sujal128005/navya_autonomouscar/docs/report/steering_marked.jpg

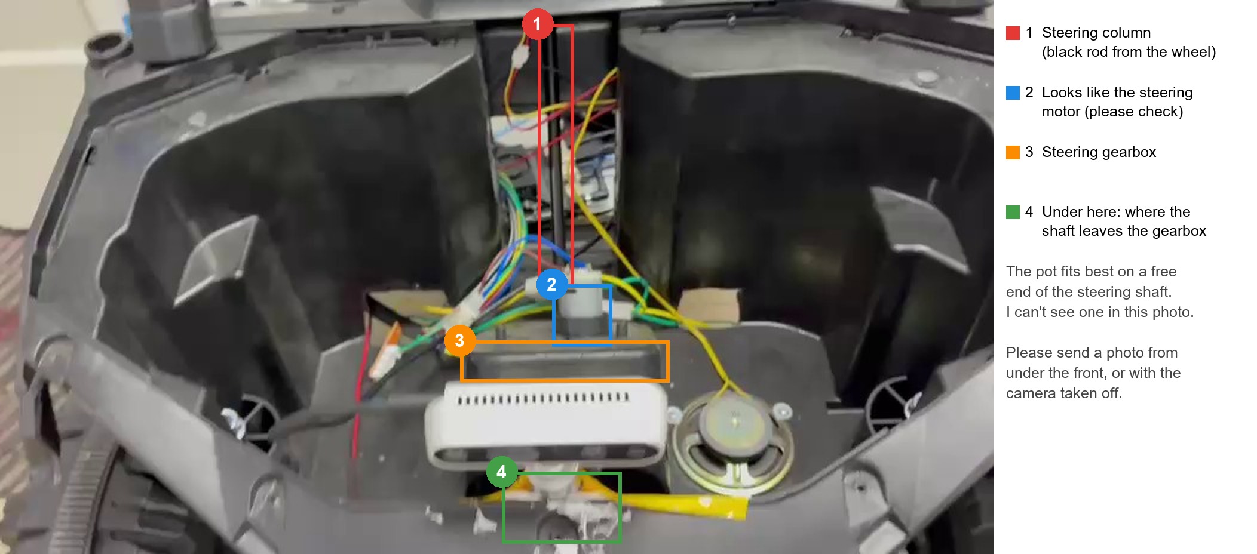
docs/report/steering_marked.jpg
