sujal128005/navya_autonomouscar/docs/wiring/photos/camera_front.jpg

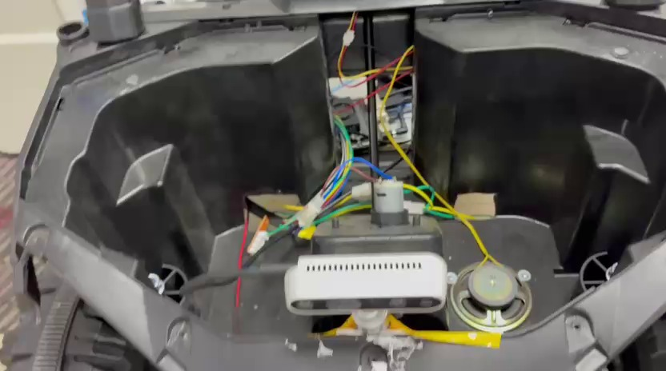
docs/wiring/photos/camera_front.jpg
