sujal128005/navya_autonomouscar/README.md

# Navya



Autonomous car built on a TZ-306 4x4 ride-on, on a student budget.

**Demo 1 (current):** drive along a straight path, see an obstacle with the
Intel RealSense D435i, slow down, stop before it, and move off again by itself
once the obstacle is taken away.

## How it works

```
 D435i depth ──USB3──► Laptop: autopilot/navya_autopilot.py
                         finds the nearest thing inside the car's path
                         picks a speed: cruise / slow / stop / resume
                              │ USB serial "D,<left>,<right>,<brake>" at 30 Hz
                              ▼
 FlySky FS-R6B ──CH2,CH5──► Arduino Uno: firmware/navya_drive
                         MANUAL / AUTO / NO_RC modes, safety stops
                              │ throttle PWM + brake per wheel
                              ▼
                  2x YL-12 controller ──► 2x 8" BLDC rear hub motor
```

Front wheels are passive: steering is zip-tied straight and the three front
toy motors are disconnected. The car (~31 kg) drives on the two rear hubs only.

The Arduino is in charge of safety. The car stops if any of these happen:

| Event | Result |
|---|---|
| CH5 switch not in AUTO | laptop commands ignored (MANUAL: stick drives) |
| Right stick (CH2) pulled back | stop + brake, in any mode |
| No receiver signal for 0.1 s | stop + brake |
| No laptop command for 0.3 s (crash, cable out) | stop + brake |
| Camera stops sending frames | laptop sends stop |
| Something right against the lens (no depth) | treated as an obstacle |

## Hardware

| Part | Used for |
|---|---|
| 2x 8" BLDC hub motor, 24 V 350 W, drum brake | rear drive |
| 2x YL-12 brushless sine-wave controller (24 V, 16 A, brake active low, cut-off 21 V) | one per hub |
| 2x 6S LiPo 22.2 V 5200 mAh | motor power |
| Arduino Uno | throttle/brake output, RC input, safety |
| FlySky FS-CT6B transmitter + FS-R6B receiver | manual driving, AUTO switch, stop |
| Intel RealSense D435i | obstacle depth |
| Laptop (Windows, Python) | autopilot |
| LDROBOT D500 LiDAR (STL-19P), on the laptop's USB | optional second obstacle sensor (`--lidar`) |
| Raspberry Pi 3B | not used yet |

## Wiring

### Arduino Uno pins (firmware v2)

| Uno pin | Goes to |
|---|---|
| D9 | LEFT controller throttle signal (purple) |
| D10 | RIGHT controller throttle signal (purple) |
| D8 | LEFT controller F/R (silver) |
| D7 | RIGHT controller F/R (silver) |
| **D11** | LEFT controller brake wire (optional), **moved from D5 in v2** |
| **D12** | RIGHT controller brake wire (optional), **moved from D6 in v2** |
| GND | BOTH controllers' throttle black wires and F/R black wires |
| D3 | receiver CH2 signal pin (right stick up/down) |
| D2 | receiver CH5 signal pin (AUTO switch) |
| **D4** | receiver **CH1** signal pin (right stick left/right = manual steering) |
| 5V / GND | receiver + / − (any channel's middle / outer pin) |
| **D5** | BTS7960 **RPWM** |
| **D6** | BTS7960 **LPWM** |
| **A3** | BTS7960 **R_EN and L_EN** (both) |
| **5V / GND** | BTS7960 **VCC / GND** |
| **A0** | steering potentiometer **middle pin** (outer pins to 5V and GND) |
| **A1** | LEFT limit switch, other side to GND (closed = at full left) |
| **A2** | RIGHT limit switch, other side to GND (closed = at full right) |
| USB | laptop |

### Battery monitor (optional, 4 resistors)

For each LiPo, wire: **LiPo + → 47 kΩ → Uno pin → 10 kΩ → GND**.
- Left battery to **A4**, right battery to **A5**.
- The battery negatives must be joined to the Arduino GND (see Power).
- Full charge (25.2 V) reads as about 4.4 V at the pin, safely under 5 V.

The phone, terminal and trip log then show each battery's voltage and %:
- **below 22.2 V:** a warning;
- **below 21.6 V for 3 s while driving:** the car stops and stays stopped until restarted.

This happens before the controllers would cut out at 21 V mid-run. If the readings are
slightly off against a multimeter, adjust `BATT_ADC_REF_V` in the firmware.

### Steering (the toy's own steering motor)

- **Disconnect the toy's blue control board from the steering motor.** Its two motor wires
  go to the BTS7960 **M+ / M−**.
- **BTS7960 B+ / B−** ← the car's **12 V battery**, through an **inline 10 A fuse** on B+.
- **Potentiometer:** fix its body to the chassis and couple its shaft to the steering shaft
  (rubber or plastic tube, or a 3D-printed adapter), so it turns with the steering. Set it
  roughly mid-way when the wheels are straight, so neither lock reaches the pot's own end.
- **Limit switches:** mount one at each lock so the linkage presses it just before the
  hard stop.
- The BTS7960's R_IS / L_IS pins are not used.
- Firmware safety: the steering motor stops on a limit switch, when the pot stops moving
  for 1.5 s while driven (stall), when the pot wire looks broken, with no radio, and
  until the steering has been calibrated.

Controller plug colours, from our bring-up:

- **Throttle plug:** black = GND, orange = +5 V out (leave unconnected), purple = signal.
- **F/R plug:** black = GND, silver = signal. Leaving it open means forward. If a wheel ever
  spins backwards, set `INVERT_LEFT` or `INVERT_RIGHT` in the firmware.
- **Brake (optional):** "Brake: Low" means pulling the brake wire to GND brakes. Without it,
  a stop is just throttle off and coast, so keep the stop distance generous.

The Uno's GND must connect to both controllers' throttle GND. Without that shared
ground the throttle signal means nothing.

Recommended additions, all cheap:

- **10 kΩ resistor** from each purple throttle wire to GND, so a disconnected or
  resetting Arduino reads as zero throttle.
- **Kill switch:** route both controllers' power-lock (ignition) wires through one
  toggle switch that someone can reach. Opening it cuts both motors, whatever the
  software is doing.

### Power

- One 6S LiPo per controller works fine. Join the two battery negatives with a proper
  wire so motor current never flows through the Arduino's ground.
- Full charge is 25.2 V; the controllers cut out at 21 V (3.5 V per cell), which
  also protects the LiPos.
- Power the Arduino before (or together with) the controllers. They refuse to start
  if they see throttle applied at power-on.
- Unplug the LiPos when the car is not being tested.

## Software setup

### 1. Flash the Arduino

1. Open `firmware/navya_drive/navya_drive.ino` in the Arduino IDE.
2. Choose board **Arduino Uno** and the right port, then click Upload.
3. Open the Serial Monitor at **250000** baud. You should see `NAVYA READY v2`, then
   `S,...` status lines 10 times a second, starting
   `S,<mode>,<CH2 µs>,<CH5 µs>,<laptop ok>,<pwm left>,<pwm right>,<brake>,...`
   (the comment at the top of the firmware lists all 17 fields).

### 2. Laptop

Python 3.10 or newer. The D435i must be on a **USB 3** (blue) port.

```bash
cd autopilot
pip install -r requirements.txt
python test_logic.py
```

`test_logic.py` checks the obstacle maths and speed logic with simulated depth
images. It needs no hardware. GitHub also runs it, and compiles the Arduino firmware,
on every push (`.github/workflows/ci.yml`): the badge at the top turns red if
something broke. Check it is green before taking the car out.

All tunable numbers live in `autopilot/config.py`.

### 3. Jetson Orin Nano (onboard computer)

The same code runs on a Jetson Orin Nano with JetPack 6.2 (Python 3.10). Set up and
tested on 3 Nov 2026 at the desk; not yet on the car.

1. Once, with the Jetson password:
   - remove `brltty` (Ubuntu's braille driver grabs the Arduino's CH340 chip);
   - install `python3-venv`;
   - add the RealSense USB rule.

   `bash jetson/setup_jetson.sh` prints the exact command if any of this is missing.
2. `bash jetson/setup_jetson.sh` creates `.venv`, Navya's own Python, so other projects
   on the Jetson keep their packages. It installs:
   - NVIDIA's GPU PyTorch (torch 2.8.0 from `pypi.jetson-ai-lab.io/jp6/cu126`);
   - RealSense, ultralytics, pyserial;
   - numpy 1.x, which the Jetson torch build needs. That's why OpenCV is pinned below 4.12.
3. Object detection:
   - put `yolo11n.pt` in `autopilot/models/`, then run `python export_models.py`;
   - it builds `yolo11n.engine` (TensorRT, FP16, about 7 minutes): 23 ms per image on the GPU.
4. Every session, from the laptop: **double-click `Navya Jetson.bat`**. It:
   - finds the Jetson on the laptop's current Wi-Fi (`jetson/find_jetson.py`) and remembers it;
   - opens the Navya menu (`navya.sh`) **on the Jetson**, after fetching the latest code;
   - opens the dashboard in the laptop's browser as soon as a drive or viewer starts.

   Q quits, as on the laptop. Without a screen (over SSH), the viewers and `--show` appear
   on the dashboard instead of in windows.

**Network:**
- the laptop and the Jetson must share one Wi-Fi: a phone hotspot or the laptop's Mobile
  hotspot. College Wi-Fi blocks device-to-device traffic.
- `ssh jetson` uses the key `~/.ssh/navya_jetson`, plus a `Host jetson` entry in
  `~/.ssh/config` that `find_jetson.py` keeps up to date.

**On the Jetson:**
- the Arduino needs the CH340 driver: `bash jetson/build_ch341.sh` (once, and after
  JetPack updates);
- serial ports are `/dev/ttyUSB*`; auto-detection picks the Arduino (CH340) and the LiDAR
  (CP210x);
- trip recordings go to the Samsung T7 SSD (`/mnt/t7ssd/navya_trips`). Plug it in before
  switching the Jetson on, or run `sudo mount /mnt/t7ssd`;
- plug the camera straight into a Jetson USB port. Through a USB-C dock it fails to start.

## Bring-up, in this order

**Every step until step 7 is done with the car on blocks (rear wheels off the ground).**

1. **Radio check.** In the Serial Monitor, move the right stick: the CH2 value must
   go up and down (~1000–2000). Flip the CH5 switch: the mode must change between
   `MANUAL` and `AUTO`.
   - If CH5 doesn't respond, your switch is on another channel. Move the D2 wire to
     the channel that changes.
   - The CT6B's knobs and switches can be reassigned with the FlySky T6 config tool.
2. **Signal-loss check.** Turn the transmitter off. The mode must change to `NO_RC`
   within a moment.
   - If it stays `MANUAL`/`AUTO`, the receiver is repeating its last signal. In that
     case the transmitter is **not** a dead-man switch: fit the kill switch from
     *Recommended additions* (Wiring) before any ground run.
3. **Manual drive.** CH5 in MANUAL, push the right stick up gently: both wheels must
   turn forward. Pull it back: brake.
4. **Find the throttle range.** CH5 in AUTO:
   ```bash
   python throttle_test.py --sweep
   ```
   - Note the first PWM at which both wheels turn and put it in `PWM_START` in the
     firmware.
   - Pick a `PWM_MAX` that gives a safe top speed. Start low (start + 40); 31 kg takes
     a while to stop. Re-upload.
   - Check both wheels together with `python throttle_test.py --speed 500`.
5. **Mount and calibrate the camera.** Mount it facing straight ahead, level
   side-to-side and tilted slightly down. Put the car on the floor with 2 m of
   empty floor ahead, then run:
   ```bash
   python calibrate_camera.py --write
   ```
6. **Camera-only check.** No motors are driven in this step:
   ```bash
   python navya_autopilot.py --dry-run --show
   ```
   - Walk in front of the car. The white overlay marks what counts as an obstacle,
     and the floor must **not** be white.
   - Watch the state go `CLEAR → SLOWING → STOPPED` as you get closer, and back to
     `RESUMING → CLEAR` 0.5 s after you step away.
7. **First ground run.** Keep `CRUISE_SPEED` low in `config.py` (130 is our tested value).
   1. Place a cardboard box about 5 m ahead.
   2. CH5 to MANUAL, then run `python navya_autopilot.py --show`.
   3. Flip CH5 to AUTO. The car moves off after 0.5 s.
   4. Measure where it actually stops. Raise `STOP_DIST_M` if it stops too close,
      then raise speed step by step.

## One-click launcher

Double-click **`Navya.bat`** in the repository folder (or make a desktop shortcut to it:
right-click > Send to > Desktop). It opens a menu:

```
 1  Pre-flight check
 2  Drive          (watch on phone)
 3  Drive + object detection + record trip
 4  Drive + lane following (steering)
 5  Drive with everything (detection, steering, record)
 L  Drive + LiDAR  (LiDAR plugged into the laptop)
 6  Camera test    (no Arduino, car never moves)
 7  Corridor viewer   8  Object detection viewer   9  LiDAR radar view
 C  Calibrate camera  S  Calibrate steering  R  Report of the last trip  T  Run the logic tests
```

Option **L** drives with the LiDAR as a second obstacle sensor (plug it in first). Every
drive option runs the pre-flight check first. If anything fails, it asks before
driving. When the program ends, press a key to get back to the menu.

## Pre-flight check (run this first, every time)

```bash
python preflight.py
```

It checks, and tells you how to fix anything wrong:
- Python packages, and that the Arduino IDE / Serial Monitor is closed;
- Arduino connected with firmware v2, transmitter on, CH5 in MANUAL, stick centred;
- steering calibrated, and battery voltages;
- camera on USB 3 and still matching its calibration (warns if it was knocked);
- LiDAR spinning and sending scans (if plugged in);
- SD card and free space, object-detection backend, hotspot on, port 8080 free, Ask Navya key.

It never moves the car. `READY` at the end means go.

## Demo-day checklist

1. LiPos charged (above 24 V).
2. Transmitter on, **SWA down** (SWA up is dual rate and shortens the stick travel),
   CH5 in **MANUAL**, right stick centred.
3. Laptop: `python navya_autopilot.py --show`, and wait for `Running`.
4. A person holds the transmitter for the whole run, ready to pull the stick back.
5. Flip CH5 to **AUTO**. The car drives off.
6. Step in front of it (or slide a box in): it slows and stops. Step away: after
   0.5 s it moves off again.
7. End the run with CH5 back to MANUAL. On the laptop, SPACE pauses and Q quits.

## Trip recorder

Add `--record` to save every run:

```bash
python navya_autopilot.py --phone --vision --record
```

Each run gets its own folder, `trip_YYYYMMDD_HHMMSS`, under `navya_trips` on the **SD card**
(found automatically when inserted), or under `autopilot/recordings` if there is none. It contains:

| File | What |
|---|---|
| `camera.mp4` | camera picture with status text and detection boxes, real-time speed |
| `depth.mp4` | depth view, with the obstacle zone in white |
| `lidar.mp4` | only with `--lidar`: the radar view |
| `telemetry.csv` | 10 rows/s: mode, state, obstacle distance, speeds, brake, PWM, RC sticks, vision reason, objects, steering, battery volts, LiDAR distance (opens in Excel) |
| `report.png` | made by `trip_report.py` (below) |
| `raw.bag` | only with `--record-raw`: the full camera data for `--replay` |

- **Disk space:** the videos use about 15 GB per hour, and `--record-raw` adds about 100 GB per hour.
  Recording stops by itself when less than 2 GB is free; the car keeps driving.
- **Trip report:** `python trip_report.py` charts the newest trip (obstacle distance, speed, state)
  and prints stop counts and time in each state. `python trip_report.py <folder>` picks a specific one.
- **Replay:** `python navya_autopilot.py --replay <trip>/raw.bag --show --vision` runs the recorded
  camera data through the current settings. It never drives the car. Use it to tune `config.py`
  and see what the car *would* have done.

## Watch from a phone

The laptop rides in the car, so add `--phone` and open the views in any phone browser:

```bash
python navya_autopilot.py --phone          # camera, depth, mode, state, obstacle distance, speed
python corridor_view.py --phone            # camera + bird's-eye map, 3D map, lane, obstacle
```

1. On the laptop, turn on **Mobile hotspot** (Windows Settings → Network → Mobile hotspot), and
   connect the phone to it. Campus Wi-Fi often blocks phone-to-laptop traffic; the hotspot
   always works.
2. The program prints the addresses to open, for example `http://192.168.137.1:8080`. Use the
   `192.168.137.x` one when on the hotspot.
3. The phone shows the live pictures and a status bar. The mode turns **green in AUTO**, yellow
   in MANUAL and red with no radio. "NO UPDATES" means the program stopped.

**Live tuning:** open **"Tune settings (live)"** on the autopilot page.
- The sliders cover cruise speed, slowest speed, start boost, slow-down and stop distances,
  resume wait, person margin, lane lookahead and trim.
- Changes apply **immediately** while driving. **Save settings** writes them into `config.py`;
  without saving, they reset when the program restarts.
- Values are limited to safe ranges, and related distances adjust themselves. For example, the
  resume distance always stays beyond the stop distance.

**Ask Navya:** tap it (optionally type a question) and a free vision AI describes the current
camera picture: people, obstacles, signs. The answer appears on the page a few seconds later.
- **It only describes; it never drives.**
- **Fallback:** it tries **Google Gemini** first (`gemini-3.5-flash-lite`). If that fails (free
  limit reached, error, timeout, empty answer), it asks **Groq** (`qwen/qwen3.8-27b`). The answer
  says which one replied, e.g. `[Gemini, 2 s]` or `[Groq, 3 s - Gemini: free limit reached]`.
  The order and models are in `config.py` (`ASK_PROVIDERS`, `GEMINI_MODEL`, `GROQ_MODEL`).
- **Free keys, no card needed:**
  1. **Gemini:** [aistudio.google.com](https://aistudio.google.com) → *Get API key*.
  2. **Groq:** [console.groq.com](https://console.groq.com) → *API Keys*.
  3. Copy `autopilot/keys.env.example` to `autopilot/keys.env` and paste the keys there.
     `keys.env` is git-ignored, so the keys never go to GitHub.
  4. One key works; two give the fallback.
- **Needs internet on the laptop.** Phones on the laptop's hotspot share the laptop's internet.
- **Free tiers may use what you send** (camera pictures of the corridor) to improve the
  provider's products, so avoid using it in private spaces.

The autopilot page has **Pause** and **Resume** buttons. Pause holds the car stopped, the same as
SPACE on the laptop. Wi-Fi can lag or drop, so **the transmitter stays the emergency stop**.
The first time, Windows may ask whether Python may use the network: allow it.

## Object detection

**YOLO11n** finds people, chairs, bags, bottles, bicycles, cars, stop signs and more in the
colour image. With the D435i, each object also gets its distance and side
(e.g. *person 2.3 m ahead*).

The model file is not in the repo. Download it once into `autopilot/models/`:

```bash
curl -L -o autopilot/models/yolo11n.pt https://github.com/ultralytics/assets/releases/download/v8.3.0/yolo11n.pt
```

Then:

```bash
cd autopilot
python vision_view.py              # D435i: objects + distance
python vision_view.py --webcam     # laptop webcam: objects only (no depth)
python vision_view.py --phone      # also on the phone page
```

- **Speed:** run `python export_models.py` once after downloading the model (needs
  `pip install openvino`). The detector then uses OpenVINO on the Intel GPU automatically:
  19 ms per frame (about 50 fps) on this laptop. Without OpenVINO it falls back to ONNX on the CPU
  (38 ms), then to PyTorch (about 75 ms).
- **Tuning:** `DETECT_CLASSES`, `DETECT_CONFIDENCE` and `DETECT_IMAGE_SIZE` in `config.py`
  control what it looks for, how sure it must be, and speed vs. small-object range.
- **Distance:** the nearer part of the middle of each box, so background showing around a person
  doesn't count.
- `vision_view.py` only looks. To drive with it, use the autopilot's `--vision` option (below).

### Driving with object detection

```bash
python navya_autopilot.py --phone --vision
```

- **People in or near the path:** the car stops `PERSON_EXTRA_MARGIN_M` (1 m) further away than
  for other obstacles, at 3.0 m instead of 2.0 m.
- **Stop sign within 2.5 m:** the car stops, waits 3 s, drives on, and ignores stop signs for 5 s
  so it can pass the sign. The phone and terminal show `STOP_SIGN` and the countdown.
  - **Print one:** a red octagon with white "STOP", at least A4 size.
  - **Place it beside the path** (0.5–1 m to the side, 0.5–1 m high) so the camera sees it. If you
    put it *in* the path, the depth check treats it as an obstacle and waits until it's removed.
- **Detection can only make the car more careful.** It runs in a separate thread; the depth
  obstacle check still runs every frame. If detections are late (over 0.5 s), they're ignored and
  the car behaves exactly as without `--vision`.
- Model loading adds about 8 s at start-up.

## Steering and lane following

### 1. Calibrate the steering (once, and again if the pot is moved)

Upload firmware v2, close the Arduino IDE, set the transmitter to **AUTO** (stick centred), then:

```bash
python steering_calibrate.py
```

1. It pulses the motor and asks **which way the wheels turned**. Answer `l` or `r`.
2. It drives to **full left and full right**, stopping at the limit switch or the end stop.
3. It moves to the middle. Nudge with **A / D** until the wheels point **straight**, then press
   **Enter**.
4. It tests left, straight, right. Positions are stored in the Arduino (EEPROM).
5. Measure the **front-wheel angle at full lock** and put it in `STEER_MAX_DEG` in `config.py`.

After that, **MANUAL mode steers with the right stick (left/right)**. Check the stick's centre
value in the Serial Monitor (the 9th field of `S,` lines) and set `RC_STEER_CENTER_US` in the
firmware if it isn't about 1500.

### 2. Lane following

```bash
python navya_autopilot.py --phone --steer
```

- The lane is the free corridor between the walls (depth camera).
- **Pure pursuit** aims at the lane centre `LOOKAHEAD_M` (1.5 m) ahead and steers along the
  arc that reaches it (wheelbase 0.745 m). It never asks for more than about 17°, so it
  steers gently.
- **Lane lost** for over 0.5 s: steer straight and creep at `LANE_LOST_SPEED`.
- Obstacle stopping and `--vision` work as before, alongside steering.
- **Tuning:**
  - Weaving side to side → longer `LOOKAHEAD_M`.
  - Too lazy in bends → shorter `LOOKAHEAD_M`.
  - Measure `CAMERA_TO_REAR_AXLE_M` on the car.

## LiDAR (second obstacle sensor)

The LDROBOT D500 kit (STL-19P sensor) plugs into the **laptop's USB** through the kit's
adapter board, so it needs no Arduino pins. It spins ~10 times a second and sees 360°
around the car, in one flat slice at its own height.

1. **Mount it** on top of the car, level, where nothing on the car blocks its view.
   Pick a height that catches legs and boxes (a low slice sees more). Measure how far
   it is behind the front bumper and put that in `LIDAR_SETBACK_M` in `config.py`
   (and `LIDAR_LATERAL_OFFSET_M` if it is off-centre).
2. **See what it sees:**
   ```bash
   python lidar_view.py            # add --phone to watch it on the phone
   ```
   Up is forward, and the grey strip is the car's path. The bottom lines show the
   nearest thing in the path and on each side.
3. **Point it forward.** Put a box about 1 m straight ahead with nothing else near the car.
   Copy the "nearest ... at sensor angle" number into `LIDAR_ANGLE_OFFSET_DEG`. Restart,
   and check the box now shows straight ahead. If left and right are swapped, set
   `LIDAR_CLOCKWISE = False`. If the nearest point is part of the car itself (a mast,
   the roll bar), raise `LIDAR_IGNORE_WITHIN_M` until it disappears from the radar.
4. **Drive with it:**
   ```bash
   python navya_autopilot.py --phone --lidar
   ```
   The car slows and stops for whichever is nearer: the depth camera's obstacle or
   the LiDAR's. The LiDAR only ever makes the car more careful. If it stops sending
   for 0.5 s, the car stops (`LIDAR_LOST`) and moves on once it is back. The phone
   gets a radar view, and `--record` saves it as `lidar.mp4`.

The LiDAR sees only its own height. Low things (a shoe, a cable) are still the
camera's job.

## Corridor viewer: lane and 3D map

`LANE_SOURCE` in `config.py` decides where the lane comes from:

- **`"walls"` (default):** the lane is the free corridor between the walls, measured by the depth
  camera. Shiny floors don't affect it. Our polished granite corridor mirrors the walls so strongly
  that colour-based strip finding is unreliable there.
- **`"strips"`:** the lane is the floor between two black strips (matte tape or tiles), found in the
  colour image.

```bash
cd autopilot
python corridor_view.py
```

This program only looks; it never drives the car. Two windows open:

- **Navya camera** has two parts:
  - The live picture with the strips (yellow) and the lane centre (green) drawn in.
  - A **bird's-eye floor map**: black tiles in yellow, anything standing on the floor in red.
  - The text shows how far the lane centre is to the left or right of the car, the lane's heading
    (+ = lane bends right), and the lane width.
- **Navya 3D** is a live 3D point cloud in real colours. Obstacles in the car's path are red and
  the strips are yellow; the car is outlined in blue.
  - Drag with the left mouse button to rotate, and use the wheel to zoom.
  - Keys **1 / 2 / 3** switch to the behind, top and side views.
- **S** saves a snapshot to `autopilot/captures/`: both pictures plus a `.ply` 3D file that opens
  in MeshLab or CloudCompare. **Q** quits.

Run `calibrate_camera.py --write` first. The floor map relies on the camera height and tilt.

| Problem | Change in `config.py` |
|---|---|
| Walls: lane edge jumps onto a bin or person by the wall | raise `WALL_MIN_LATERAL_M` |
| Walls: low skirting or clutter ignored / picked up | adjust `WALL_MIN_HEIGHT_M` |
| Strips not found (shown grey, not yellow) | raise `LANE_DARK_MAX` (e.g. 90) |
| Shadows or reflections show up as strips | lower `LANE_DARK_MAX` (e.g. 50) |
| Grout lines or cables picked up | raise `LANE_MIN_WIDTH_M` |

## Tuning (autopilot/config.py)

| Symptom | Change |
|---|---|
| Stops too close / bumps the obstacle | raise `STOP_DIST_M` and `SLOW_DOWN_DIST_M`, or lower `CRUISE_SPEED` |
| Stops for nothing (floor) | re-run `calibrate_camera.py --write`; raise `FLOOR_CLEARANCE_M` |
| Stops for things beside the path | lower `CORRIDOR_HALF_WIDTH_M` |
| Misses small/low objects | lower `FLOOR_CLEARANCE_M` or `MIN_OBSTACLE_POINTS` |
| Random `BLIND` stops (shiny floor) | raise `BLIND_CHECK_FRACTION`, or 1.01 to turn it off |
| Waits too long after the obstacle is gone | lower `RESUME_DELAY_S` |
| Stalls while creeping up to the obstacle | raise `CREEP_SPEED` (or `PWM_START` in the firmware is too low) |
| Veers right | raise `TRIM` a little (0.02 steps); veers left: lower it |
| Too jerky when moving off | lower `RAMP_UP_PER_10MS` in the firmware |

## Troubleshooting

- **"Could not pick the Arduino port"**: pass `--port COM5` (Device Manager shows the
  number) or set `SERIAL_PORT` in `config.py`.
- **"camera is on USB 2"**: the cable or port is USB 2. Phone charger cables and cheap
  USB-C hubs are USB 2 even when marked "PD 3.0". Plug the camera straight into the
  laptop with a USB 3 data cable. On USB 2 it still works (depth 30 fps + colour
  15 fps was measured at 28 fps), but with no margin. 424x240 is not offered on USB 2.
- **Camera sends no frames** (often after re-plugging): the camera got stuck. The
  pre-flight check and the autopilot reset it by themselves and try again.
- **Mode stays `NO_RC`**: check receiver power (5V/GND) and that it is bound to the
  transmitter (receiver LED solid).
- **Wheels don't move in AUTO but the laptop shows speed**: is the status `laptop ok`
  field 1? Is the stick pulled back? Is `PWM_START` high enough?
- **Wheels won't start after power-on**: the controller saw throttle at power-on.
  Power-cycle the controllers with the Arduino already running.
- **Upload fails with "cannot set com-state" (CH340 clone Uno)**: Windows installed the newer
  CH340 driver. In Device Manager roll it back to version **3.5.2019.1**.
- **Upload fails with "not in sync" / Python says "Access is denied" on the port**: something
  else has the port open. Close the Serial Monitor (and any other Navya program), then retry.
- **Steering state `STALL`**: the motor was driven for 1.5 s without the pot moving. It retries
  after 2 s. If it keeps happening, something blocks the wheels or the pot coupling slips.
- **Phone page doesn't load**: hotspot on? Phone joined to it? Allow Python through the
  Windows firewall when asked.

## Repository layout

```
Navya.bat                              one-click menu: pre-flight, drive modes, viewers, calibration
firmware/navya_drive/navya_drive.ino   Arduino Uno: RC + laptop -> throttle, brake, steering, battery, safety
autopilot/config.py                    every tunable number
autopilot/navya_autopilot.py           the driving program (--phone --vision --steer --lidar --record ...)
autopilot/preflight.py                 checks everything before a run
autopilot/navya_link.py                serial link to the Arduino
autopilot/obstacle.py                  depth frame -> nearest obstacle in the car's path
autopilot/speed_planner.py             distance -> speed (cruise / slow / stop / resume)
autopilot/battery.py                   LiPo low-voltage warning and stop
autopilot/lane.py                      lane from the walls (depth) or black floor strips (colour)
autopilot/lane_follow.py               pure-pursuit steering towards the lane centre
autopilot/steering_calibrate.py        teaches the Arduino full left / straight / full right
autopilot/vision.py                    YOLO11n object detection + distance per object
autopilot/vision_rules.py              people and stop-sign rules; detection thread
autopilot/vision_view.py               object detection viewer (never drives)
autopilot/export_models.py             makes the fast OpenVINO / ONNX copies of the model
autopilot/lidar.py                     LiDAR packets -> 360° scans; nearest thing in the path
autopilot/lidar_view.py                LiDAR radar view (window / phone)
autopilot/corridor_view.py             lane, bird's-eye map and 3D map viewer (never drives)
autopilot/phone_stream.py              phone page: live views, status, buttons, sliders
autopilot/live_settings.py             phone sliders: live changes, saved to config.py
autopilot/ask_navya.py                 "Ask Navya": free vision AI (Gemini, Groq fallback)
autopilot/keys.env.example             template for the free AI keys (copy to keys.env)
autopilot/trip_recorder.py             saves videos + telemetry of a drive (SD card if inserted)
autopilot/trip_report.py               chart and summary of a recorded trip
autopilot/calibrate_camera.py          measures camera height and tilt from the floor
autopilot/throttle_test.py             bench test and PWM calibration
autopilot/test_logic.py                offline tests (no hardware needed)
.github/workflows/ci.yml               GitHub runs the tests and compiles the firmware on every push
docs/PROJECT_REPORT.md                 project report: goal, design, status, plan
docs/steering_parts.md                 steering parts and why they were chosen
docs/navya_bill_robu.xlsx              the Robu.in bill (what to order now vs later)
```

## Next steps (after Demo 1)

- LiDAR: reader, radar view and `--lidar` done; mount, align and test on the car. Mapping later.
- The Uno's pins are all used. Wheel-speed sensors or more inputs need an Arduino Mega.
- Steering: done in software (toy motor + BTS7960 + potentiometer); test once parts arrive.
- Wheel speed feedback (hall signals) for closed-loop speed and odometry (needs the Mega).
- Move the autopilot onto an onboard computer (ROS 2).
