sujal128005/navya_autonomouscar/docs/wiring/photos/overview.jpg

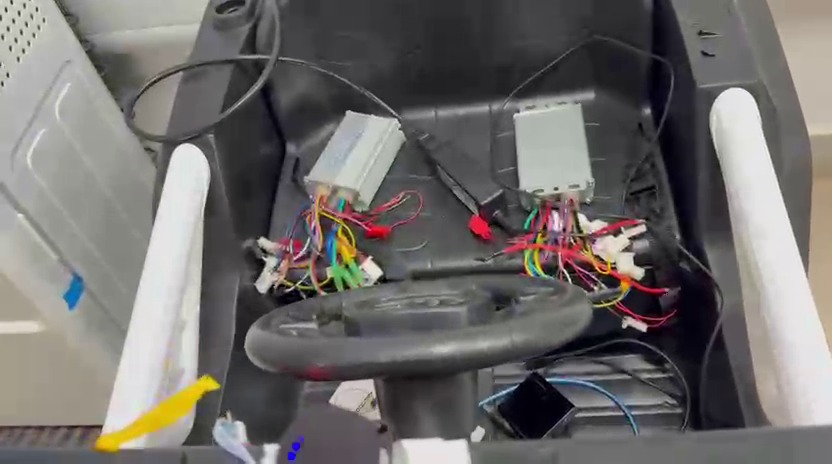
docs/wiring/photos/overview.jpg
