sujal128005/navya_autonomouscar/docs/navya_bill_robu.xlsx

Sheet: Bill
Navya - Steering & Upgrades Bill (Robu.in)
Professor's decision: keep the toy's own steering. Column L: 'Yes' = order now (the final cart, Rs 2,302); 'Later' = considered, not buying now; 'No' = servo conversion, not used. Prices incl. GST, checked on Robu.in 31-Oct-2026. Blue cells = quantities/prices you can change; totals update.
# | Section | Item | Robu.in product | SKU | Qty | Unit price (₹, incl. GST) | Line total (₹) | Stock on Robu | Link | Why we need it | Needed for current car?
1 | Toy steering | Steering motor driver | SmartElex BTS7960 DC Motor Driver Module (43 A, 6-27 V) | R189064 | 1 | ₹1273 | ₹1273 | In stock | Open (https://robu.in/product/smartelex-bts7960-dc-motor-driver-module/) | ADDED for the current car: lets the Arduino drive the toy's own steering motor left/right with PWM. Powered from the car's existing 12 V battery. | Yes
2 | Toy steering | Steering angle sensor | 10K Ohm 3Pin 15mm Shaft Potentiometer | 607345 | 2 | ₹29 | ₹58 | In stock | Open (https://robu.in/product/10k-ohm-3pin-15mm-shaft-potentiometer-pack-of-3/) | ADDED for the current car: coupled to the steering shaft so the Arduino knows the wheel angle (the toy motor has no sensor). Qty 2 = one spare. | Yes
3 | Steering | Steering servo | Pro-Range Brushless BL51180-24V 180kg·cm Metal Gear Digital Servo - 180° | R251585 | 1 | ₹7329 | ₹7329 | In stock | Open (https://robu.in/product/pro-range-bl51180-24v-180kgcmr-digital-servo/) | Turns the front axle. 165-205 kg·cm; runs on 19.2-25.2 V = straight from the 6S LiPo (no UBEC). Chosen over the 60 kg·cm DS5160 because the steering needs a firm push and must cope with roads. | No
4 | Steering | Servo arm | CNC Aluminum Steering Servo Horn Arm for Futaba Standard 25T | 28414 | 1 | ₹89 | ₹89 | In stock | Open (https://robu.in/product/cnc-aluminum-steering-servo-horn-arm-futaba-standard-25t-aluminum/) | Connects the servo to the steering link. Check the spline fit on arrival. | No
5 | Steering | Ball joints (rod ends) | Reprap Delta Kossel mini ball-headed buckle joint kit, 12 pcs M4 | R261537 | 1 | ₹299 | ₹299 | In stock | Open (https://robu.in/product/reprap-delta-kossel-mini-5347-delta-ball-headed-2/) | Pivoting ends for the link between servo arm and steering linkage. | No
6 | Steering | Link rod | M4 x 20mm Male to Female Brass Hex Standoff - 6 pcs | 942325 | 1 | ₹167 | ₹167 | In stock | Open (https://robu.in/product/m4-x-20mm-male-to-female-brass-hex-threaded-pillar-standoff-spacer-6-pcs/) | Screwed together to make an adjustable M4 rod between the two ball joints (Robu has no M4 threaded rod). | No
7 | Steering | Servo mounting bracket | NOT AVAILABLE on Robu for the DS5160 size | - | 1 | ₹0 | ₹0 | Not on Robu | - | Make locally: aluminium angle or 3D-printed plate (servo is about 65 x 30 x 48 mm). | No
8 | Wiring | End-stop switches | KW4-Z5F150-SPDT Roller Lever Micro Switch-5A | R132437 | 2 | ₹23 | ₹46 | In stock | Open (https://robu.in/product/kw4-z5f150-spdt-roller-lever-micro-switch-5a1-5n/) | One at full left, one at full right, so steering can't strain against the end stops. | Yes
9 | Wiring | Fuse holders | Waterproof In Line Blade Fuse with Holders - 5 pcs | 699636 | 1 | ₹629 | ₹629 | In stock | Open (https://robu.in/product/waterproof-in-line-blade-fuse-with-holders-for-car-fuse-replacement-socket-5pcs/) | Inline fuse on the steering motor's 12 V lead to the BTS7960. | Yes
10 | Wiring | Fuses 10 A | Littelfuse 0287010.PXCN Blade Fuse 10A 32V | R182177 | 4 | ₹17 | ₹68 | In stock | Open (https://robu.in/product/0287010-pxcn-littlefuse-32v-1ka-blade-fuse-10a-automotive-fuses-rohs/) | 10 A fuses for the steering 12 V lead, plus spares. | Yes
11 | Wiring | LiPo tap (male) | SafeConnect XT-60 Male 14AWG 15cm Pigtail | 6783 | 1 | ₹89 | ₹89 | In stock | Open (https://robu.in/product/xt60-male-w-12awg-silicon-wire-10cm-1pcsbag/) | Clean, unpluggable tap off the LiPo for the servo power. | Later
12 | Wiring | LiPo tap (female) | SafeConnect XT-60 Female 14AWG 15cm Pigtail | 57749 | 1 | ₹74 | ₹74 | In stock | Open (https://robu.in/product/xt60-male-w-12awg-silicon-wire-10cm-1pcs-bag/) | Mates with the male pigtail. | Later
13 | Wiring | Power wire red (metres) | 18AWG High Voltage Silicone Wire 3000V - Red | R164399 | 2 | ₹57 | ₹114 | In stock | Open (https://robu.in/product/18awg-high-voltage-silicone-wire-3000v-red/) | Power wiring. Qty = metres (Robu sells per metre). | Yes
14 | Wiring | Power wire black (metres) | 18AWG High Voltage Silicone Wire 3000V - Black | R164398 | 2 | ₹57 | ₹114 | In stock | Open (https://robu.in/product/18awg-high-voltage-silicone-wire-3000v-black/) | Power wiring. Qty = metres. | Yes
15 | Safety | Emergency stop button | ONPOW LAS1-A22Y-01TSB 22mm 1NC Emergency Stop Switch IP65 | R255027 | 1 | ₹1071 | ₹1071 | In stock | Open (https://robu.in/product/onpow-las1-a22y-01tsb-22mm-1nc-flat-round-emergency-stop-switch-ip65-4/) | Big red button that cuts motor power, whatever the laptop or Arduino is doing. | Later
16 | Safety | Power cut relay | LANBOO JD2912 Car/Auto Relay 40A 24V 4-pin (1NO) | R165230 | 1 | ₹170 | ₹170 | In stock | Open (https://robu.in/product/jd2912-lanboo-car-auto-relay-40a-24v-4-pin-shape-back1no/) | Switched by the e-stop; opens the motor controllers' power. Not needed if the e-stop goes in the power-lock wires. | Later
17 | Safety | Relay socket | LANBOO LB-J4 Pin Car/Auto Relay 40A Connector (1NO) | R165248 | 1 | ₹219 | ₹219 | In stock | Open (https://robu.in/product/lb-j4-pin-lanboo-car-auto-relay-40a-connector1no/) | Socket with wires for the relay. | Later
18 | Battery | Main switch, left battery | 12V/24V Battery Disconnect Isolator Switch 100A, Red + 2 keys + 4 copper rings | R265245 | 1 | ₹909 | ₹909 | In stock | Open (https://robu.in/product/12v24v-car-battery-power-switch-disconnect-isolator-red2-keys4pcs-copper-ring4pcs-heat-shrink/) | Key switch in the left LiPo's + lead: turn off instead of unplugging at the controller. 100 A continuous. | Later
19 | Battery | Main switch, right battery | 12V/24V Battery Disconnect Isolator Switch 100A, Black + 2 keys + 4 copper rings | R265246 | 1 | ₹909 | ₹909 | In stock | Open (https://robu.in/product/12v24v-car-battery-power-switch-disconnect-isolator-black2-keys4pcs-copper-ring4pcs-heat-shrink/) | Same for the right LiPo. Two separate switches keep the batteries separate (never joined). | Later
20 | Storage | 256 GB microSD card | SanDisk Ultra 256GB Micro SD Card 150MB/s Class 10 | R271422 | 1 | ₹3999 | ₹3999 | In stock | Open (https://robu.in/product/sandisk-ultra-micro-sd-card-256gb-class-10-memory-card/) | Trip recordings (about 16 h of video). Kingston 256GB (₹1,853) is out of stock; see Notes. | Later
 |  |  |  |  |  | Toy steering subtotal | ₹1331
 |  |  |  |  |  | Steering subtotal | ₹7884
 |  |  |  |  |  | Wiring subtotal | ₹1134
 |  |  |  |  |  | Safety subtotal | ₹1460
 |  |  |  |  |  | Battery subtotal | ₹1818
 |  |  |  |  |  | Storage subtotal | ₹3999
 |  |  |  |  |  | GRAND TOTAL (all rows) | ₹17626
 |  |  |  |  |  | ORDER NOW ('Yes' rows) | ₹2302
 |  |  |  |  |  | Servo conversion ('No' rows, not used) | ₹7884
 |  |  |  |  |  | Considered, not buying now ('Later' rows) | ₹7440
 |  |  |  |  |  | Shipping (if any) is extra; Robu shows it at checkout.

Sheet: Route B (alternative)
Route B - keep the toy steering motor (now chosen: see 'Toy steering' rows on the Bill sheet)
Cheaper parts but more work: the sensor must be fitted to the steering shaft and the Arduino runs the position loop. Power from the car's existing 12 V battery.
# | Section | Item | Robu.in product | SKU | Qty | Unit price (₹, incl. GST) | Line total (₹) | Stock on Robu | Link | Why we need it | Needed for current car?
1 | Steering (alt.) | Motor driver | SmartElex BTS7960 DC Motor Driver Module | R189064 | 1 | ₹1273 | ₹1273 | In stock | Open (https://robu.in/product/smartelex-bts7960-dc-motor-driver-module/) | Drives the toy's own steering motor both ways. The cheaper 'Double BTS7960' (₹329) is out of stock. | Yes
2 | Steering (alt.) | Angle sensor | Magnetic encoder sensor module AS5600 | R175153 | 1 | ₹159 | ₹159 | In stock | Open (https://robu.in/product/magnetic-encoder-sensor-module-as5600/) | Measures the steering shaft angle without contact. Check a diametric magnet is included. | No
 |  |  |  |  |  | Steering (alt.) subtotal | ₹1432
 |  |  |  |  |  | GRAND TOTAL (all rows) | ₹1432
 |  |  |  |  |  | NEEDED FOR CURRENT CAR | ₹1273
 |  |  |  |  |  | Servo-conversion items (not needed now) | ₹159
 |  |  |  |  |  | Shipping (if any) is extra; Robu shows it at checkout.

Sheet: Notes
Navya bill - notes
Source: every item is a Robu.in product page, price and stock read on 31-Oct-2026 (prices incl. GST).
Prices and stock change often; open each link and recheck before paying.
Decision (31-Oct-2026)
Professor: do not change the steering; work with the toy's own steering motor and gearbox.
So the car needs a motor driver (BTS7960) and an angle sensor (10k potentiometer on the steering shaft).
Servo, servo arm, ball joints, link standoffs and bracket stay in the bill for reference, marked 'No'.
Toy steering motor power: the car's existing 12 V battery (no purchase). Arduino: driver RPWM/LPWM on two PWM pins,
potentiometer on A0, limit switches on two digital pins; brakes move off D5/D6 (handled in firmware).
AS5600 magnetic sensor (SKU R175153, ₹159) is an alternative to the potentiometer, but Robu's module comes WITHOUT the magnet.
Choices and alternatives
Servo: upgraded from DS5160 60 kg·cm (₹2,329 + ₹1,829 UBEC) to BL51180-24V 180 kg·cm (₹7,329, no UBEC) after the
steering-effort test needed a firm push. 150/160 kg·cm servos (DS51150-12V, DS51160-24V) were out of stock.
Servo bracket: Robu has no bracket for this large servo class (about 65 x 30 x 48 mm). Make one from aluminium angle or 3D-print it.
Battery switches: 1-2-BOTH selector switches were avoided on purpose; they join both LiPos, which is unsafe if their charge differs.
Link rod: Robu has no M4 threaded rod, so M4 male-female brass standoffs are screwed together into an adjustable rod.
256 GB card: Kingston Canvas Select Plus 256GB (SKU R231495, ₹1,853) was cheaper but OUT OF STOCK.
256 GB card for heavy, continuous recording: SanDisk V30 256GB High Endurance (SKU R165746, ₹7,699, in stock).
E-stop relay + socket (₹389) are optional if the e-stop is wired in series with both controllers' power-lock wires.
Route B motor driver: 'Double BTS7960 43A' (SKU 456144, ₹329) was OUT OF STOCK; SmartElex BTS7960 used instead.
Before ordering
Done: steering-effort test (needs a firm push). The professor then decided to keep the toy steering.
Final cart (1-Nov-2026): BTS7960, 2 pots, 2 limit switches, fuse holders, 4 x 10 A fuses, 2 m red + 2 m black wire = Rs 2,302.
Wiring with the toy steering (firmware v2)
Throttle stays on D9/D10; brakes move D5/D6 -> D11/D12; BTS7960 RPWM/LPWM on D5/D6, enable on A3; pot on A0; limit switches A1/A2; receiver CH1 on D4; battery monitor A4/A5.
