sujal128005/navya_autonomouscar/docs/Navya_wiring.pdf

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

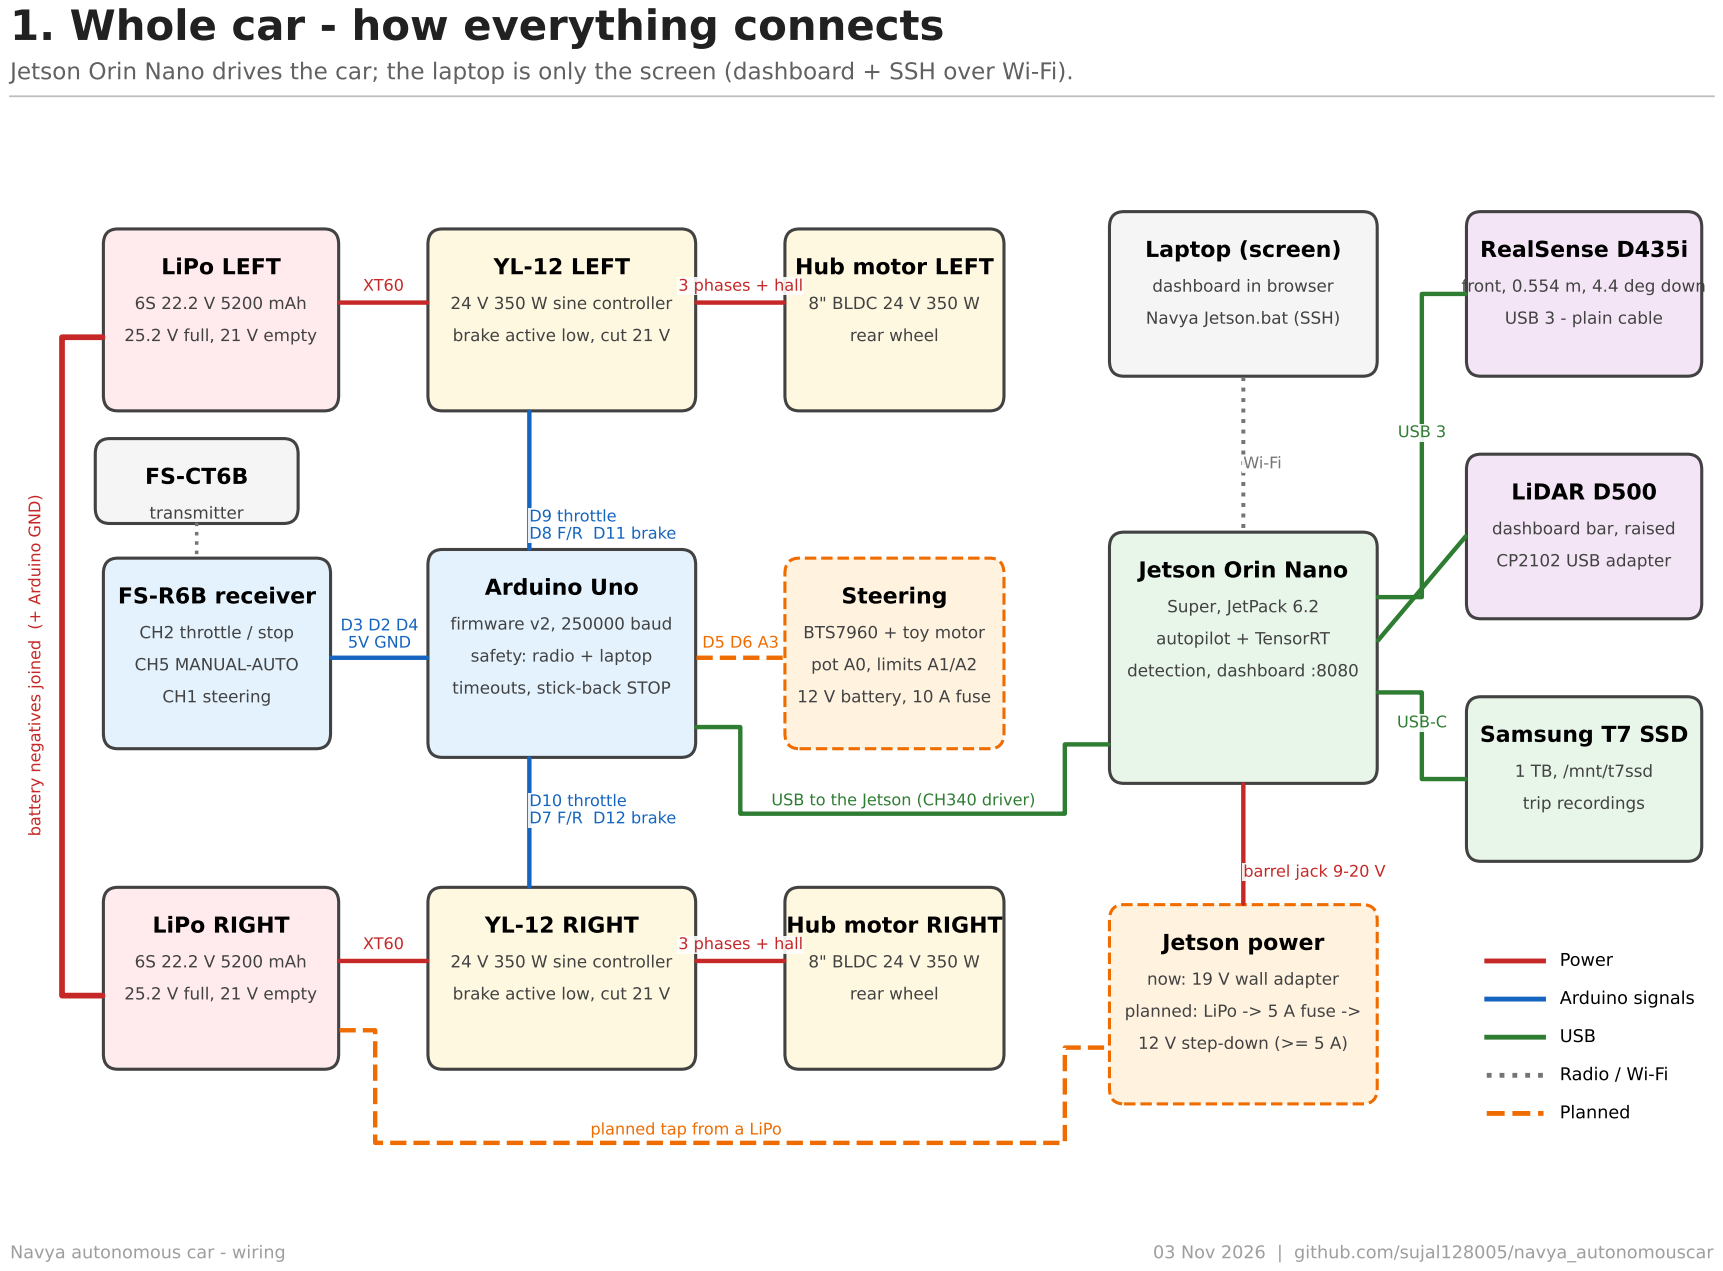
[picture p8: page 1]

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

Device | Where | Notes
RealSense D435i camera | Jetson USB-A, straight in (USB 3, 5 Gbit/s) | Plain cable only. Through a USB-C dock it fails to start ('Port reset failed').
Arduino Uno (CH340) | Jetson USB-A | Needs the ch341 driver: bash jetson/build_ch341.sh
LiDAR D500 via CP2102 adapter | Jetson USB-A | 230400 baud; found automatically
Samsung T7 SSD 1 TB | Jetson USB-C | Mounted at /mnt/t7ssd at start-up; trips in navya_trips
Power | Jetson DC barrel jack 5.5 x 2.5 mm | 9-20 V, max 4.2 A. Now: 19 V wall adapter
Network | Wi-Fi | Same Wi-Fi as the laptop (phone hotspot / laptop hotspot)

# 3. Jetson - ports, network and software

What goes into which Jetson port, and what to check if something is missing.

Navya autonomous car - wiring | 03 Nov 2026 | github.com/sujal128005/navya_autonomouscar
Start a session (laptop) | Double-click Navya Jetson.bat: finds the Jetson on the Wi-Fi, opens the menu on it, opens the dashboard when a drive starts.
Dashboard | http://<jetson-ip>:8080 in the laptop's browser (the batch file opens it).
Pre-flight | Menu option 1 - checks Arduino, radio, camera + calibration, LiDAR, SSD, detection, network.
Code on the Jetson | ~/navya_autonomouscar, own Python in .venv (jetson/setup_jetson.sh); object detection = TensorRT engine (export_models.py).
Serial ports | /dev/ttyUSB*: Arduino = CH340 (ch341 driver), LiDAR = CP2102 (cp210x). Found by USB ID.
If the SSD is missing | Plug it in before switching on, or run: sudo mount /mnt/t7ssd
If the camera is missing | Plain cable straight into a Jetson port; unplug 10 s and re-plug; no docks or hubs.
If the Arduino is missing | lsusb shows CH340 but no /dev/ttyUSB -> bash jetson/build_ch341.sh

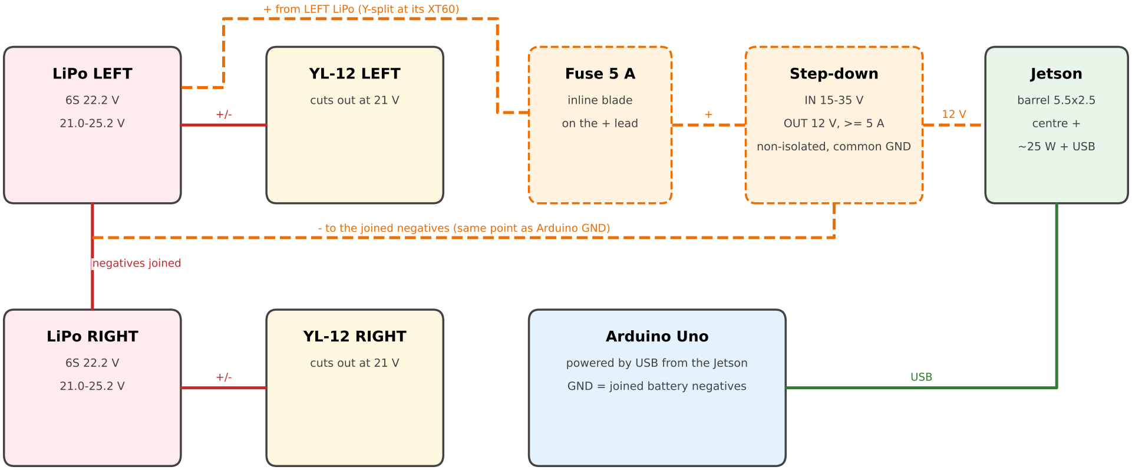
[picture p9: figure]
LiPo LEFT; LiPo RIGHT; YL-12 LEFT; cuts out at 21 V; YL-12 RIGHT; negatives joined; Fuse 5 A; inline blade; on the + lead; Step-down; OUT 12 V, >= 5 A; non-isolated, common GND; Jetson; barrel 5.5x2.5; centre +; ~25 W + USB; + from LEFT LiPo (Y-split at its XT60); Arduino Uno; powered by USB from the Jetson; GND = joined battery negatives; USB

- to the joined negatives (same point as Arduino GND)

# 4. Power - today, and the Jetson on the car (planned)

Jetson barrel jack accepts 9-20 V, max 4.2 A (19 V adapter supplied). A 6S LiPo gives 21-25.2 V.

1. Why 12 V and not 19 V: a 19 V converter needs a few volts of headroom, which a 6S pack near empty (21 V) does not have. 12 V sits safely inside the Jetson's 9-20 V range at every battery voltage.
2. Converter to buy: step-down (buck), input covering 21-26 V (e.g. 8-35 V), output 12 V fixed or adjustable, at least 5 A / 60 W. Set it to 12.0 V with a multimeter BEFORE connecting the Jetson.
3. Fuse 5 A on the LiPo + lead to the converter. Barrel plug 5.5 x 2.5 mm, centre positive (check before plugging in).
4. The LiPo keeps feeding the Jetson after the controllers cut out at 21 V: switch the Jetson off and unplug the converter after a session, or the pack is drained below 3 V per cell. The battery monitor (A4/A5) warns at 22.2 V.
5. Power-on order: Jetson first (it powers the Arduino over USB), then the controllers - they refuse to start if they see throttle at power-on. Unplug all LiPos when the car is not being tested.

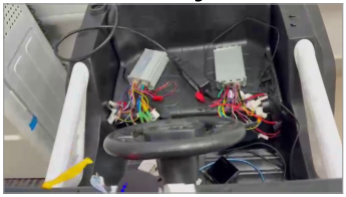
[picture p10: figure]

Both YL-12 controllers behind the steering wheel, with their plugs.

Controllers and steering wheel

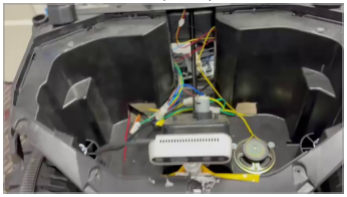
[picture p11: figure]

Front bonnet, centred, rigid bracket; 0.554 m high, 4.4 deg down. Toy steering motor below.

RealSense camera (front)

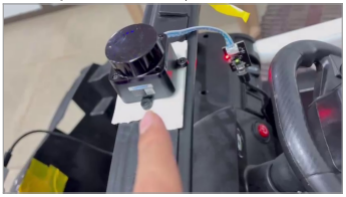
[picture p12: figure]

Raised above the camera, level; CP2102 adapter next to it. 0.365 m behind the bumper, 0.10 m left.

LiDAR (dashboard bar)

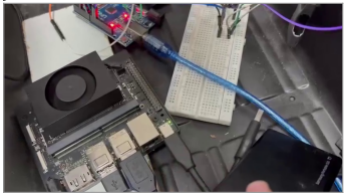
[picture p13: figure]

Jetson Orin Nano with the Samsung T7; Arduino (top) on the blue USB cable.

Jetson + SSD (footwell)

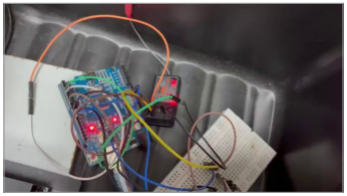
[picture p14: figure]

Uno with jumper wires to the FS-R6B receiver and the breadboard rails (GND / 5 V).

Arduino + receiver

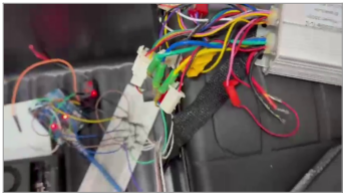
[picture p15: figure]

YL-12 signal plugs (throttle, F/R, brake) and the joined grounds.

Controller harness

# 5. On the car (stills from the walk-round video, 3 Nov 2026)

Replace with HD photos when convenient: docs/wiring/photos/, then run make_wiring_pdf.py again.

# 6. Before every run

Short version of the README bring-up. The car moves only with CH5 in AUTO.

1 | Car | Wheels up on blocks for the first test of the day. Camera and LiDAR not knocked (pre-flight checks the camera).
2 Transmitter | ON, SWA down, CH5 MANUAL, right stick centred. One person holds it the whole run.
3 Jetson | SSD plugged in, then power on. Laptop and Jetson on the same Wi-Fi.
4 | Laptop | Double-click Navya Jetson.bat. Option 1 = pre-flight: everything OK?
5 | LiPos | Connect the controllers' LiPos last (Arduino already running).
6 Drive | Option 2 (or 3 with detection + recording). Dashboard opens by itself. CH5 to AUTO.
7 | Stop | Right stick back = stop and brake, any mode. Q in the terminal ends the program.
8 After | CH5 MANUAL, unplug the LiPos, switch the Jetson off. Trips are on the SSD (navya_trips).
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
