sujal128005/navya_autonomouscar/docs/wiring/photos/arduino_receiver.jpg

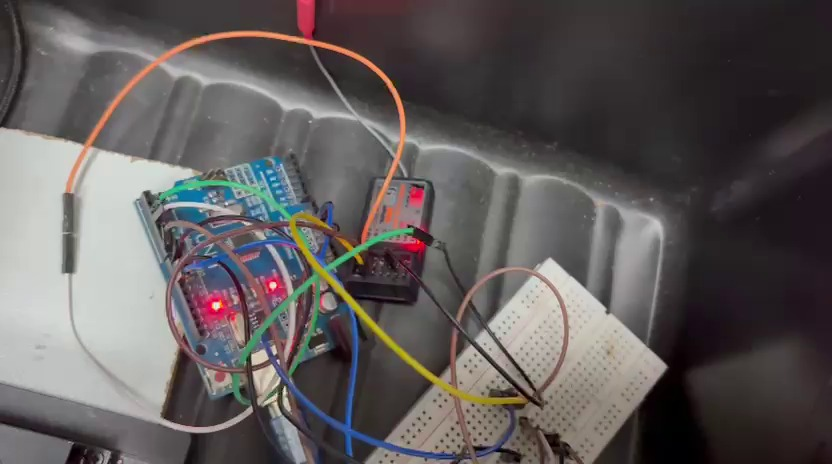
docs/wiring/photos/arduino_receiver.jpg
