sujal128005/navya_autonomouscar/docs/wiring/photos/controllers.jpg

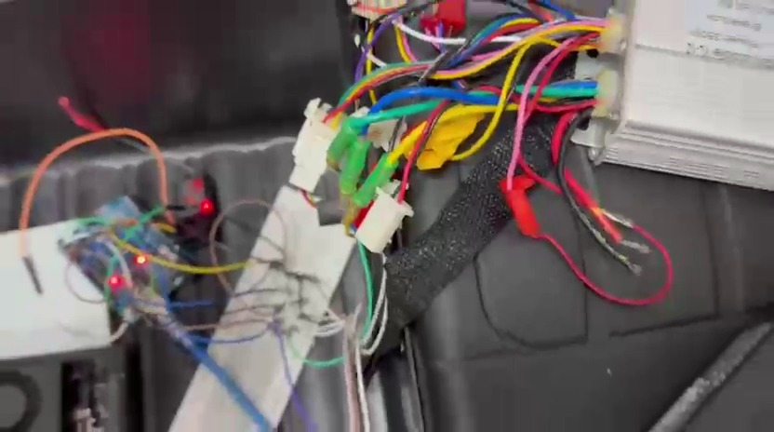
docs/wiring/photos/controllers.jpg
