sujal128005/navya_autonomouscar/docs/wiring/photos/jetson_ssd.jpg

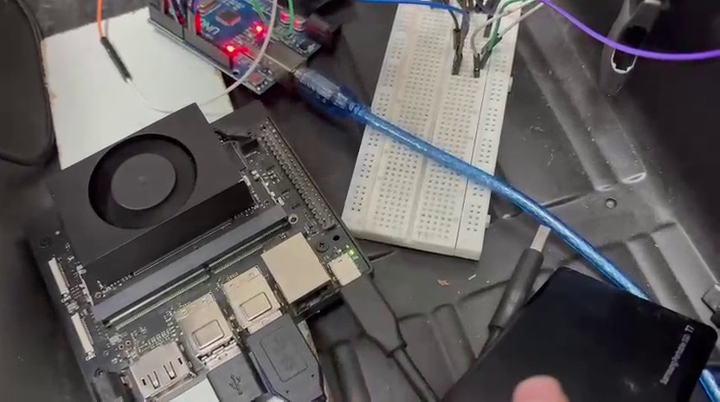
docs/wiring/photos/jetson_ssd.jpg
