sujal128005/navya_autonomouscar/autopilot/config.py

"""Navya autopilot settings. Every laptop script reads this file.

Distances are metres. Speeds are 0..1000, a share of the Arduino's
PWM_START..PWM_MAX throttle range (see firmware/navya_drive/navya_drive.ino).
"""

# --- Arduino link ---
SERIAL_PORT = None          # e.g. "COM5"; None = auto-detect the Uno
SERIAL_BAUD = 250000          # must match Serial.begin() in navya_drive.ino

# --- RealSense depth stream ---
DEPTH_WIDTH = 640
DEPTH_HEIGHT = 480
DEPTH_FPS = 30
DEPTH_STRIDE = 2            # use every 2nd pixel each way; plenty for this job

# --- Camera mounting (python calibrate_camera.py --write fills the first two) ---
CAMERA_HEIGHT_M = 0.554      # lens centre above the floor
CAMERA_PITCH_DEG = 4.4      # positive = tilted down
CAMERA_LATERAL_OFFSET_M = 0.0   # positive = camera right of the car's centre line
CAMERA_SETBACK_M = 0.0      # lens behind the front bumper; subtracted from distances

# --- Driving corridor: only points inside this box count as obstacles ---
CORRIDOR_HALF_WIDTH_M = 0.45    # car is ~0.62 m wide; half-width plus a 0.14 m margin
FLOOR_CLEARANCE_M = 0.15       # ignore anything lower (the floor itself, tape, cables)
MAX_OBSTACLE_HEIGHT_M = 1.6     # ignore anything higher (ceiling, overhead lights)
DETECT_MIN_M = 0.2
DETECT_MAX_M = 4.5
OBSTACLE_PERCENTILE = 5         # nearest 5% of corridor points sets the distance
MIN_OBSTACLE_POINTS = 800      # fewer points than this = sensor noise, not an obstacle

# The D435i cannot see closer than ~0.3 m: those pixels read 0. If most of the
# centre of the image has no depth, something is right in front of the lens.
# Shiny floors can also read as "no depth"; set 1.01 to switch this check off.
BLIND_CHECK_FRACTION = 0.6

# --- Speed plan ---
CRUISE_SPEED = 130
CREEP_SPEED = 80            # slowest moving speed while closing in on an obstacle
SLOW_DOWN_DIST_M = 3.8      # start slowing down when an obstacle is this close
STOP_DIST_M = 2.0           # stop here; the car coasts ~0.9 m more (first ground run)
RESUME_DIST_M = 2.4         # path counts as clear again beyond this distance...
RESUME_DELAY_S = 0.5        # ...for this long, then the car moves off again
START_BOOST_SPEED = 250     # extra throttle for moving off from a stop (31 kg needs a push)...
START_BOOST_S = 0.4         # ...for this long, then back to the planned speed
DISTANCE_HISTORY = 3        # use the nearest reading of the last N frames

# --- Straight-line trim: positive = right wheel faster. Car veers right -> raise it.
TRIM = 0.0

# --- Battery monitor (needs the 47k/10k dividers on A4/A5; 6S LiPo) ---
BATTERY_WARN_V = 22.2           # below this (3.7 V/cell): warning on phone and terminal
BATTERY_STOP_V = 21.6           # below this for BATTERY_STOP_S while driving: stop and stay stopped
BATTERY_STOP_S = 3.0            # (voltage dips briefly under load; ignore short dips)

# --- Steering and lane following (python navya_autopilot.py --steer) ---
# Steering commands run -1000 (full left) .. 1000 (full right); steering_calibrate.py
# teaches the Arduino where full left / straight / full right are.
WHEELBASE_M = 0.745             # front to rear axle (measured)
CAMERA_TO_REAR_AXLE_M = 0.95    # camera lens is this far in front of the rear axle (measure)
STEER_MAX_DEG = 25.0            # front-wheel angle at full lock (measure after calibrating)
LOOKAHEAD_M = 1.5               # aim at the lane centre this far ahead (longer = smoother, lazier)
STEER_RATE_PER_S = 1500         # steering command may change at most this much per second
LANE_LOST_HOLD_S = 0.5          # lane missing for less than this: keep the last steering
LANE_LOST_SPEED = 80            # lane missing for longer: steer straight and creep at this speed

# --- LiDAR (LDROBOT D500 kit on the laptop's USB; python lidar_view.py / --lidar) ---
LIDAR_PORT = None               # e.g. "COM7"; None = find it automatically
LIDAR_BAUD = 230400
LIDAR_ANGLE_OFFSET_DEG = -1.0   # sensor angle that points straight ahead (measured 2 Nov 2026)
LIDAR_CLOCKWISE = True          # sensor angles grow clockwise seen from above (checked on the car)
LIDAR_SETBACK_M = 0.365         # LiDAR behind the front bumper; subtracted from distances
LIDAR_LATERAL_OFFSET_M = -0.10  # positive = LiDAR right of the car's centre line (here: 10 cm left)
LIDAR_IGNORE_WITHIN_M = 0.15    # ignore returns this close (the car's own mast, cables)
LIDAR_MIN_INTENSITY = 10        # weaker returns are noise (0..255)
LIDAR_MIN_POINTS = 3            # points needed in the corridor to count as an obstacle
LIDAR_MAX_AGE_S = 0.5           # with --lidar: no new scan for this long = stop, as for lost depth

# --- Ask Navya (phone button; display only) ---
ASK_PROVIDERS = ["gemini", "groq"]     # tried in this order; the next one answers if one fails
GEMINI_MODEL = "gemini-3.5-flash-lite" # free tier, accepts images
GROQ_MODEL = "qwen/qwen3.8-27b"        # free tier, accepts images
ASK_TIMEOUT_S = 20

# --- Object detection (python vision_view.py) ---
DETECT_CONFIDENCE = 0.4     # ignore detections the model is less sure about than this
DETECT_IMAGE_SIZE = 480     # model input size; smaller = faster, larger = sees smaller things
                            # (after changing it, run export_models.py again)
DETECT_BACKEND = "auto"     # auto = fastest available: "tensorrt" (Jetson), "openvino" (Intel GPU), "onnx", "torch"
DETECT_CLASSES = [          # what to look for ([] = all 80 COCO classes)
    "person", "bicycle", "car", "motorcycle", "bus", "truck", "stop sign", "dog", "cat",
    "chair", "bench", "backpack", "handbag", "suitcase", "bottle", "cup", "potted plant",
    "dining table", "couch", "tv", "laptop", "cell phone",
]
DETECT_THREADS = 4          # CPU threads for YOLO; the rest stay free for the driving loop

# --- Object-aware driving (python navya_autopilot.py --vision) ---
# Detection only ever makes the car more careful; the depth obstacle check always runs.
PERSON_EXTRA_MARGIN_M = 1.0     # people: stop this much further away than for other obstacles
PERSON_SIDE_MARGIN_M = 0.3      # a person this far outside the car's corridor still counts
STOP_SIGN_TRIGGER_M = 2.5       # stop when a stop sign is closer than this...
STOP_SIGN_WAIT_S = 3.0          # ...wait this long...
STOP_SIGN_IGNORE_S = 5.0        # ...then drive on, ignoring stop signs for this long to pass it
VISION_MAX_AGE_S = 0.5          # detections older than this are ignored

# --- Trip recorder (python navya_autopilot.py --record) ---
RECORD_DIR = "auto"         # auto = the SSD below if mounted, else an SD card / USB stick,
                            # else autopilot/recordings; or a folder path
RECORD_SSD_DIR = "/mnt/t7ssd/navya_trips"   # Jetson: Samsung T7 (shared with the drone project)
RECORD_FPS = 15             # video frames per second
RECORD_LOG_HZ = 10          # telemetry rows per second
RECORD_MIN_FREE_GB = 2.0    # stop recording (not driving) when the disk gets this full

# --- Corridor viewer and lane finder (python corridor_view.py) ---
# "walls":  lane = free corridor between the walls, from depth (works on shiny floors)
# "strips": lane = floor between two black tape/tile strips, from the colour camera
LANE_SOURCE = "walls"
WALL_MIN_HEIGHT_M = 0.15    # wall points: from this height...
WALL_MAX_HEIGHT_M = 1.5     # ...up to this one
WALL_MIN_FORWARD_M = 0.5
WALL_MAX_FORWARD_M = 5.0
WALL_MIN_LATERAL_M = 0.35   # ignore things right in front of the car (people, boxes) as walls
WALL_FIT_TOLERANCE_M = 0.10
WALL_MAX_LANE_WIDTH_M = 6.0

# Both lane sources: sanity checks and drawing range.
LANE_MIN_SAMPLES = 8        # 10 cm steps (walls) / 4 cm rows (strips) needed per edge
LANE_MIN_WIDTH_M_TOTAL = 0.6    # a lane narrower than this is rejected
LANE_MAX_STRIP_ANGLE_DEG = 10   # the two edges must be roughly parallel
LANE_MAX_HEADING_DEG = 35
LANE_MAX_FORWARD_M = 4.0    # edges are fitted and drawn up to here

# Strip lane only (LANE_SOURCE = "strips").
LANE_DARK_MAX = 70          # a floor cell is black tile if darker than this (0-255)...
LANE_DARK_RATIO = 0.5       # ...and darker than this share of the floor's median brightness
LANE_MIN_WIDTH_M = 0.05     # ignore dark bits narrower than this (grout lines, cables)
LANE_MAX_WIDTH_M = 3.5

# Viewer display.
VIEW_FPS = 15               # depth + colour together; 15 is safe even on USB 2
VIEW_POINT_STRIDE = 3       # 3D view draws every 3rd pixel each way
BEV_RES_M = 0.02            # bird's-eye floor map: 2 cm per cell
BEV_HALF_WIDTH_M = 2.0      # map covers 2 m either side of the car...
BEV_MIN_FORWARD_M = 0.5     # ...from 0.5 m...
BEV_MAX_FORWARD_M = 6.0     # ...to 6 m ahead
