sujal128005/navya_autonomouscar/(commit log)

2026-07-13 Add frozen Pi-Arduino interface contract
2026-10-29 Demo 1: straight-line drive with depth-camera stop and auto-resume
    Arduino Uno firmware drives both YL-12 controllers (throttle PWM, F/R,
    optional brake), reads FlySky CH2/CH5 for MANUAL/AUTO and operator stop,
    and stops on lost radio or a silent laptop. The laptop autopilot finds the
    nearest D435i depth point inside the car's corridor (floor removed using
    calibrated camera height and tilt) and plans cruise/slow/stop/resume.
    Includes camera calibration, throttle bench test and offline tests.
2026-10-29 Firmware: throttle and stick ranges from the first bench test
    Wheels start at ~75 PWM, so PWM_START 55 -> 75 and PWM_MAX 110 -> 130.
    CH2 on our FS-CT6B centres at ~1464 and reaches ~1756 with SWA down, so
    manual forward now spans 1520..1740 and stick-back stop is below 1400.
2026-10-29 calibrate_camera: copy depth frames instead of holding librealsense buffers
    Holding 30 un-copied frames exhausted the driver's frame pool and the
    pipeline stopped delivering frames after ~16 ("Frame didn't arrive").
    [calibrate_camera.py]
2026-10-29 Tune stopping from the first ground run
    The car coasted ~0.9 m past the stop command (no brake wire, 31 kg), so
    stop at 2.0 m, slow from 3.8 m with a lower creep speed, resume beyond
    2.4 m. Also records this car's camera calibration (0.555 m, 12.2 deg)
    and the 200 cruise speed used for first runs.
2026-10-30 Ignore small floor returns: floor clearance 0.15 m, min 800 points
    Demo-day recalibration (0.559 m, 14.6 deg) left a ~450-point false
    obstacle at ~1.8 m. A person is still seen beyond 4 m; a 0.5 m box from
    about 2.8 m.
    [config.py, test_logic.py]
2026-10-30 Corridor viewer: lane between black tile strips, bird's-eye map, 3D map
    lane.py re-projects the colour image onto the floor using the camera
    calibration, finds the nearest black strip on each side of the car and
    fits the lane centre (offset, heading, width). corridor_view.py shows the
    lane on the live picture, a bird's-eye floor map with obstacles, and a
    rotatable 3D point cloud; S saves PNGs and a .ply. Never drives the car.
2026-10-30 Lane: reject implausible lanes instead of drawing wrong lines
    Width is now measured 2 m ahead (not at the bumper, where badly fitted
    strips cross), and a lane is dropped if it is narrower than 0.6 m, wider
    than 3.5 m, its strips are not parallel within 10 deg, or it turns more
    than 35 deg. On the glossy corridor floor, wall reflections had produced
    a 0.01 m wide lane.
    [config.py, lane.py]
2026-10-30 Lane from the corridor walls (depth), now the default
    On the polished granite corridor, wall reflections defeat colour-based
    strip finding. WallLaneFinder takes the innermost point standing 0.15-1.5 m
    above the floor on each side, every 10 cm ahead, and RANSAC-fits a line
    per side. On real corridor frames: width 1.8-2.0 m, heading within 3 deg.
    LANE_SOURCE = "strips" keeps the black-strip finder for taped lanes.
2026-10-30 Phone view: stream camera, depth/3D views and status to a phone browser
    phone_stream.py is a small stdlib web server (MJPEG views + JSON status,
    no installs). navya_autopilot.py --phone adds the colour camera at 15 fps
    and shows mode/state/obstacle/speed, with Pause/Resume buttons (pause only
    ever holds the car stopped). Colour-only frame sets no longer count as a
    camera dropout; only 0.5 s without depth stops the car.
    corridor_view.py --phone serves the camera+bird's-eye and 3D views, lane
    and obstacle, with 3D view presets.
    [corridor_view.py, navya_autopilot.py, phone_stream.py]
2026-10-30 Move off faster after an obstacle clears
    Resume wait 1.5 s -> 0.5 s, and a 0.4 s start boost (speed 250) whenever
    the car moves off from a stop: at cruise 130 the 31 kg car crept away.
2026-10-30 Autopilot --vision: stop further from people, stop at stop signs
    YOLO runs in a background thread on colour + aligned depth (VisionWorker)
    so the 30 Hz depth obstacle loop never waits for it. VisionRules can only
    add caution: a person in the path counts as 1 m closer (stop at 3.0 m),
    a stop sign within 2.5 m holds the car 3 s, then it drives on and ignores
    signs for 5 s. Detections older than 0.5 s are ignored. Phone view shows
    the boxes, objects and STOP_SIGN countdown.
2026-10-30 Detection 3.5x faster: OpenVINO on the Intel GPU, ONNX fallback
    export_models.py makes ONNX and OpenVINO copies of YOLO11n; the detector
    picks the fastest available (DETECT_BACKEND = auto). On the i7-1260P /
    Iris Xe: PyTorch CPU 71 ms, ONNX CPU 38 ms, OpenVINO GPU 19 ms per frame,
    same detections. Worst driving-loop delay while detecting: 53 -> 14 ms.
2026-10-30 Trip recorder (SD card), trip report and raw replay
    --record saves camera.mp4, depth.mp4 (real-time, 15 fps) and a 10 Hz
    telemetry.csv per run, to the removable drive with the most free space
    (SD card) or autopilot/recordings; it stops itself below 2 GB free.
    --record-raw adds a RealSense .bag, and --replay <bag> runs a recording
    through the current settings without driving. trip_report.py charts
    obstacle distance, speed and state and counts stops.
2026-10-30 Docs: steering parts list (servo route, motor+sensor route, e-stop)
2026-10-30 Docs: Robu.in bill spreadsheet for steering, wiring, e-stop and 256 GB card
    Every line is a Robu.in product with SKU, link, price (incl. GST) and
    stock as checked on 2026-10-31; totals are formulas. Route B and the
    out-of-stock alternatives are on separate sheets/notes.
    [navya_bill_robu.xlsx]
2026-10-30 Bill: 180 kg-cm BL51180-24V servo, 10 A fuses, battery isolator switches
    Steering needed a firm push, so the 60 kg-cm DS5160 + UBEC became the
    BL51180-24V (runs from 6S directly). 5 A fuses -> 10 A for the 24 V
    servo lead. Two keyed 100 A isolators, one per LiPo. Total Rs 16,295,
    matching the Robu cart.
    [navya_bill_robu.xlsx]
2026-10-30 Bill: keep the toy steering (professor's decision), mark what the current car needs
    Adds the BTS7960 driver and a 10k steering-angle potentiometer for the
    toy's own steering motor. Servo-conversion rows are kept but marked 'No'.
    Needed for the current car: Rs 9,742; servo items not needed: Rs 7,884.
    [navya_bill_robu.xlsx]
2026-10-31 Steering for the toy motor (BTS7960 + pot) and lane following
    Firmware v2: position control of the toy steering motor via a BTS7960
    and a potentiometer on A0, limit switches on A1/A2, stall cut-off,
    calibration stored in EEPROM, manual steering on CH1 (D4), steering in
    the D command. Brakes move to D11/D12. Compiles for the Uno (26% flash).
    steering_calibrate.py finds direction, both locks and straight-ahead.
    lane_follow.py: pure pursuit to the lane centre 1.5 m ahead; lane lost
    -> straight and creep. navya_autopilot.py --steer wires it in, with
    steering on the phone, terminal and trip log. 19 offline tests pass.
    [config.py, lane_follow.py, navya_autopilot.py, navya_drive.ino, navya_link.py, steering_calibrate.py, test_logic.py, trip_recorder.py]
2026-10-31 Pre-flight check, live tuning from the phone, battery monitor, Ask Navya
    - preflight.py: checks packages, Arduino IDE, Arduino/firmware/radio/
    steering/batteries, camera USB 3 + calibration drift, SD card, detection
    backend, hotspot, port 8080, API key; never moves the car.
    - Phone page: 'Tune settings (live)' sliders applied on the next frame,
    clamped, related distances kept consistent, Save writes config.py.
    - Battery monitor: firmware reads both LiPos via 47k/10k dividers on
    A4/A5 (status grows to 17 fields); warn < 22.2 V, latched stop after
    3 s < 21.6 V while driving. Shown on phone, terminal, trip log.
    - Ask Navya: phone button sends the camera picture + depth readings to
    C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
    [ask_navya.py, battery.py, config.py, live_settings.py, navya_autopilot.py, navya_drive.ino, navya_link.py, phone_stream.py]
2026-10-31 Ask Navya: free Gemini first, Groq fallback (no Anthropic key)
    Replaces the Claude-only path with free-tier providers tried in order
    (config.ASK_PROVIDERS = gemini, groq): Gemini gemini-3.5-flash-lite via
    generateContent, then Groq qwen/qwen3.8-27b via its OpenAI-style API,
    both with stdlib HTTP (no new packages). A provider that fails (free
    limit, error, timeout, empty answer) falls through to the next, and the
    answer says who replied. Keys from env or git-ignored autopilot/keys.env
    (template keys.env.example). Claude remains only as an opt-in provider.
    [ask_navya.py, config.py, preflight.py, test_logic.py]
2026-10-31 Launcher menu, GitHub checks, LiDAR (reader, radar view, --lidar), project report
    - Navya.bat: one-click menu; every drive runs the pre-flight check first
    - .github/workflows/ci.yml: logic tests + firmware compile on every push
    - lidar.py / lidar_view.py: D500 (STL-19P) packets -> 360 scans, path distance,
    radar view; --lidar feeds the speed planner and stops if the LiDAR goes quiet
    - Arduino auto-detect ignores the LiDAR's CP210x adapter
    - pre-flight checks the LiDAR; drops the stale anthropic package hint
    - 3 new tests (26 total); docs/PROJECT_REPORT.md for the professor
2026-10-31 Review fixes before the full test day
    Firmware
    - steering stall timer restarts whenever the motor is off; before, a stall (or a
    long motor-off spell) could lock the steering into STALL for good
    - battery pins: detect an unwired (floating) pin with the pull-up, so it reads 0
    instead of a random voltage that could trigger the low-battery stop
    Laptop
    - low-battery stop ignores implausible readings (< 15 V); pre-flight warns instead
    - steering_calibrate keeps the Arduino in raw mode while waiting for keys, so it
    cannot steer by itself with an old calibration; waits out a stall before each end
    - LiDAR search skips non-USB (Bluetooth) COM ports, which can hang on open
    - matplotlib added to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
    [navya_bill_robu.xlsx]
2026-11-02 Link: keep a line that arrives in two reads together
    readline() with a 0.1 s timeout can return half a line. The banner then read as
    'NAVYA READY' with no version, and pre-flight reported firmware '?' on a v2 board.
    The test now feeds the banner in two pieces.
2026-11-02 Link: recognise firmware v2 from its CFG line too
    The CH340 link occasionally drops a byte; when that hits the banner, pre-flight
    showed firmware '?' on a v2 board. Only v2 reports 'steering=' in CFG, so that
    line now also marks the firmware as v2.
2026-11-02 Camera resets itself when stuck; LiDAR drops the first half turn
    - preflight and the autopilot: if the D435i sends no frames (seen after
    re-plugging), reset it once and try again
    - USB 2 advice corrected: depth 30 + colour 15 was measured at 28 fps on USB 2;
    424x240 is not offered there. Phone charger cables and cheap hubs are USB 2
    - LidarParser drops the first, partial turn, so pre-flight no longer reports
    'few returns' (36 instead of ~500 points)
    [lidar.py, navya_autopilot.py, preflight.py, test_logic.py]
2026-11-02 LiDAR position measured on the car: forward -1 deg, clockwise, 0.365 m behind the bumper, 0.10 m left of centre
2026-11-02 Camera calibrated on the car, mounted level: 0.565 m, 1.6 deg down
    Cross-check on a wall 2.7 m ahead: camera 2.73 m, LiDAR 2.67 m.
2026-11-02 Stick-back stop below 1300 us instead of 1400
    On the car today the throttle stick rested at 1408-1416 us (demo day: ~1464), so
    the brake flickered on with the stick untouched; in AUTO that would stop the car at
    random. Full back reads 1116-1252 us, so a firm pull still stops it. Pre-flight's
    'stick not centred' range follows (1340-1519 us).
2026-11-02 Link: ignore a status line with an unknown mode
    On the bench a dropped byte turned AUTO into 'AUO'; the autopilot treated that one
    line as 'not in AUTO', braked and then restarted with the start boost.
2026-11-02 Link counts the damaged status lines it drops; the autopilot reports them on exit
    [navya_autopilot.py, navya_link.py, test_logic.py]
2026-11-02 Serial link at 250000 baud instead of 115200
    115200 is 2.1% off on a 16 MHz Uno, and the CH340 clone then drops single bytes:
    13-19 damaged status lines a minute while the camera streamed. 250000 is exact
    (UBRR 7): 0 damaged in 600 lines under the same load.
    [config.py, navya_drive.ino]
2026-11-02 Autopilot: say why the LiDAR counts as lost (age of last turn, packet counts)
    On the wheels-up bench run the LiDAR was 'lost' six times in a minute, which no
    separate test reproduces; this records the details next time.
2026-11-02 Camera re-mounted rigidly after it nodded forward on hard stops: 0.554 m, 4.4 deg down
2026-11-02 Pre-flight: check the laptop's own battery
    On 2 Nov the laptop reached 4% during a run (the USB hub's PD pass-through did not
    keep up), hit Windows' critical-battery trigger and slept, which cut the camera,
    Arduino and LiDAR. FAIL below 20%, WARN below 40%.
    [preflight.py]
2026-11-02 Report: results of the 2 November on-car tests
    Measured stops (box: rests 1.10 m away; person: 1.8-2.0 m), safety stops tested
    with the wheels in the air, what was found and fixed, updated next steps.
2026-11-03 docs: handoff for setting up the Jetson as the onboard computer
2026-11-03 Jetson: setup script (own venv with GPU PyTorch, RealSense, ultralytics)
2026-11-03 Jetson setup: a removed brltty (config files left) no longer counts as installed
2026-11-03 Run on Linux / the Jetson as well as Windows
    - keyboard_input.read_key: one key without ENTER on Windows and Linux (also over
    SSH); steering_calibrate keeps sending 'hold still' while it waits on Linux too
    - object detection: TensorRT engine on the Jetson GPU (export_models.py builds it),
    PyTorch-on-GPU fallback
    - pre-flight: program list via ps, Jetson power mode, NetworkManager hotspot
    (10.42.0.1), TensorRT counts as fast detection
    - trip recorder finds SD cards / USB sticks under /media on Linux
    - navya.sh: the Navya.bat menu for Linux
2026-11-03 Jetson setup: keep numpy 1.x (Jetson torch build) by pinning opencv-python<4.12
2026-11-03 TensorRT export: no silent fallback to ONNX, no ultralytics auto-installs
    On the Jetson ultralytics auto-installed onnx and with it numpy 2, which broke the
    Jetson torch build; the resulting ImportError fell through to the ONNX export.
    [export_models.py]
2026-11-03 README: Jetson setup section
2026-11-03 gitignore: TensorRT engines (built per device)
2026-11-03 Pre-flight on the Jetson: dashboard on the laptop via its hotspot (no phone)
2026-11-03 Recordings go to the Jetson's Samsung T7 SSD (/mnt/t7ssd/navya_trips) when it is mounted
2026-11-03 Jetson: build the missing ch341 driver (Arduino's CH340 chip) for the JetPack kernel
2026-11-03 Never take the LiDAR's CP210x adapter for the Arduino; pre-flight names a missing CH340 driver
    On the Jetson the Arduino had no port (no ch341 driver), so the only USB-serial port,
    the LiDAR's, was picked as the Arduino.
    [navya_link.py, preflight.py, test_logic.py]
2026-11-03 Pre-flight on the Jetson: dashboard address on whatever Wi-Fi the laptop shares
2026-11-03 Link: read what has arrived and split lines ourselves instead of readline()
    On the Jetson (ch341 driver built for JetPack's kernel) byte-by-byte readline() got the
    end of the last line back over and over (~118 kB/s from a 25 kB/s link); reading
    in_waiting chunks gets every line intact (500 B/s = 10 status lines).
2026-11-03 Pre-flight: name the fix when the Samsung SSD is plugged in but not mounted
    [preflight.py]
2026-11-03 Dashboard: show the Jetson's real address (Linux), say 'laptop or phone'
2026-11-03 Navya Jetson.bat: drive with the Jetson from the laptop in one click
    - jetson/find_jetson.py finds the Jetson on whatever Wi-Fi the laptop is on (last
    address first, then a scan for SSH checked with the laptop's key) and saves it
    - the batch file opens the Navya menu on the Jetson over SSH (pulling the latest
    code first) and opens the dashboard in the browser once a drive or viewer starts
    - viewers and --show fall back to the dashboard when there is no screen (SSH),
    with Q in the terminal to quit
2026-11-03 README: Navya Jetson.bat, network and Jetson notes; menu says dashboard
2026-11-03 docs: Navya_wiring.pdf - landscape wiring document (6 pages) and its generator
    Overview diagram, every Arduino pin, Jetson ports/network/troubleshooting, power today
    and the planned LiPo -> 5 A fuse -> 12 V step-down -> Jetson (barrel jack 9-20 V), photos
    from the 3 Nov walk-round video, and the before-every-run checklist. Regenerate with
    python docs/wiring/make_wiring_pdf.py after wiring changes.
2026-11-03 Project report: the Jetson as onboard computer (3 Nov bench test), fixes, next steps
    Also corrects the camera calibration in section 4 (0.554 m / 4.4 deg) and points to
    docs/Navya_wiring.pdf.
2026-11-04 docs: complete wiring as one 16:9 image, and its generator
2026-11-09 docs: complete project record PDF (29 Oct - 9 Nov) and its generator
    Navya_complete_record.pdf: history day by day, all wiring (including the new
    relay steering), every steering test, firmware and software, problems and fixes,
    where we are stuck (relay clicks, motor does not move) and the full to-do list.
    The appendices are read from the repository when it is built.
    [make_full_record.py, pulse1.py]
